PierreCuv/PowerVBT/(commit log)

2026-04-17 init: project structure, README, BOM, algorithm doc, firmware skeleton
2026-06-17 Initial commit : capteur VBT (XIAO ESP32-S3 + MPU6050)
    - Firmware BLE avec fusion Madgwick (vitesse verticale concentrique)
    - Detection de reps, calibration gyro, deep sleep wake-on-motion
    - Page web Web Bluetooth (interface temps reel) pour GitHub Pages
    - Modeles 3D OpenSCAD : assemblage + boitier (sangle + aimants)
    [vbt-assembly.scad, vbt-case.scad]
2026-06-18 Fiabilise la detection de reps, la liaison BLE et le bus I2C
    Detection de reps repensee (cause des reps ratees ou mal comptees) :
    - Machine a etats basee sur la VITESSE verticale integree plutot que sur
    l'acceleration brute : ATTENTE -> DESCENTE -> MONTEE.
    - Gere l'ordre des phases selon l'exercice : squat/bench (excentrique puis
    concentrique) comme souleve de terre (concentrique direct).
    - Detecte la transition bas du mouvement par le renversement de vitesse
    (passage par zero) et ancre vVert=0 a ce point pour annuler la derive.
    - Zero Velocity Update fenetre (250 ms) tolerant au tremblement : compte
    desormais une rep capteur tenu en main, sans immobilite prealable.
    - Mesure et notif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
2026-06-18 Documente l'alimentation et le choix du circuit marche/arret (EN)
    Ajoute hardware/POWER.md qui consigne l'analyse electrique derriere le
    choix du circuit d'allumage, pour garder les decisions tracables :
    - circuit d'alim du XIAO ESP32-S3 releve sur le schema officiel v1.5
    (chargeur SGM40567 ~110 mA, regulateur SGM6029, power-path Q1) ;
    - recherche sur la protection batterie : le XIAO n'assure PAS de
    protection sur-decharge (schema sans DW01/8205, SGM40567 = chargeur
    pur), confirme par datasheet et forum Seeed ;
    - batterie utilisee = LiPo 680 mAh AVEC son propre PCM (DW01 + 8205) ;
    - decision : interrupteur sur EN (batterie connectee en permanence,
    charge possible eteint) plutot que s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
